sparkfun/SPI_Shortcut/Hardware/SPIShortcut.brd

## EAGLE design Hardware/SPIShortcut.brd (2013-08-22)

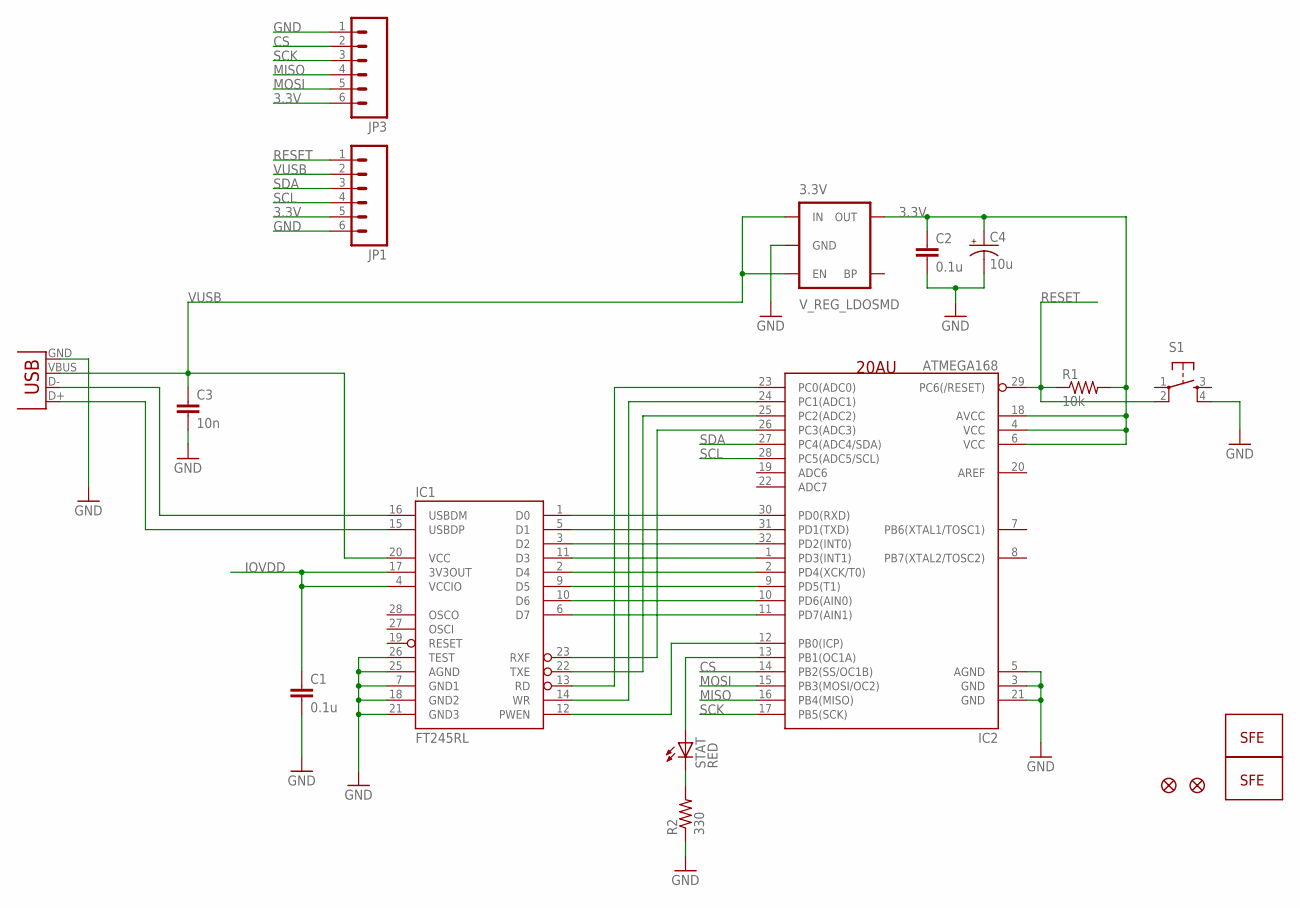
[picture p1: schematic SPIShortcut.sch]

Parts:
3.3V: V_REG_LDOSMD; SOT23-5
C1, C2: 0.1u; 0402-CAP
C3: 10n; 0402-CAP
C4: 10u; EIA3216
IC1: FT245RL; SSOP28DB
IC2: ATMEGA168; TQFP32-08
JP1, JP3: M06SIP; 1X06
R1: 10k; 0402-RES
R2: 330; 0402-RES
S1: TAC_SWITCHSMD; TACTILE_SWITCH_SMD
STAT: RED; LED-0603
U$3: LOGO-SFENEW; SFE-NEW-WEBLOGO
U$5, U$6: FIDUCIAL1X2; FIDUCIAL-1X2
U$7: LOGO-SFESK; SFE-LOGO-FLAME
X1: USBSMD; USB-MINIB

Connections:
3.3V: 3.3V.5 (OUT), C2.1, C4.A (+), IC2.4 (VCC), IC2.6 (VCC), IC2.18 (AVCC), JP1.5, JP3.6, R1.2
CS: IC2.14 (PB2(SS/OC1B)), JP3.2
GND: 3.3V.2 (GND), C1.2, C2.2, C3.2, C4.C (-), IC1.7 (GND1), IC1.18 (GND2), IC1.21 (GND3), IC1.25 (AGND), IC1.26 (TEST), IC2.3 (GND), IC2.5 (AGND), IC2.21 (GND), JP1.6, JP3.1, R2.1, S1.4, X1.GND
IOVDD: C1.1, IC1.4 (VCCIO), IC1.17 (3V3OUT)
MISO: IC2.16 (PB4(MISO)), JP3.4
MOSI: IC2.15 (PB3(MOSI/OC2)), JP3.5
unnamed: IC1.1 (D0), IC2.30 (PD0(RXD))
unnamed: IC1.5 (D1), IC2.31 (PD1(TXD))
unnamed: IC1.3 (D2), IC2.32 (PD2(INT0))
unnamed: IC1.11 (D3), IC2.1 (PD3(INT1))
unnamed: IC1.2 (D4), IC2.2 (PD4(XCK/T0))
unnamed: IC1.9 (D5), IC2.9 (PD5(T1))
unnamed: IC1.10 (D6), IC2.10 (PD6(AIN0))
unnamed: IC1.6 (D7), IC2.11 (PD7(AIN1))
unnamed: IC1.23 (RXF), IC2.26 (PC3(ADC3))
unnamed: IC1.16 (USBDM), X1.D-
unnamed: IC1.15 (USBDP), X1.D+
unnamed: IC1.22 (TXE), IC2.25 (PC2(ADC2))
unnamed: IC1.14 (WR), IC2.24 (PC1(ADC1))
unnamed: IC1.13 (RD), IC2.23 (PC0(ADC0))
unnamed: IC1.12 (PWEN), IC2.12 (PB0(ICP))
unnamed: IC2.13 (PB1(OC1A)), STAT.A
unnamed: R2.2, STAT.C
RESET: IC2.29 (PC6(/RESET)), JP1.1, R1.1, S1.2
SCK: IC2.17 (PB5(SCK)), JP3.3
SCL: IC2.28 (PC5(ADC5/SCL)), JP1.4
SDA: IC2.27 (PC4(ADC4/SDA)), JP1.3
VUSB: 3.3V.1 (IN), 3.3V.3 (EN), C3.1, IC1.20 (VCC), JP1.2, X1.VBUS

Notes on the sheet:
20AU

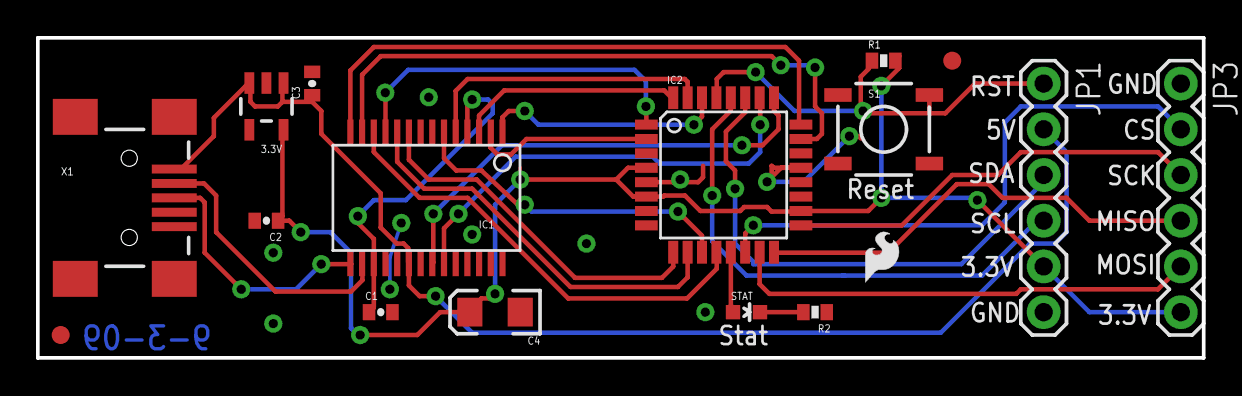
[picture p2: board SPIShortcut.brd from above]

Board: 2 copper layers, 64.8 x 17.8 mm, 18 parts (1 on the bottom side), 28 nets.
